ealex/hfBandPassFilterBlock/bandPass2/top.jpg

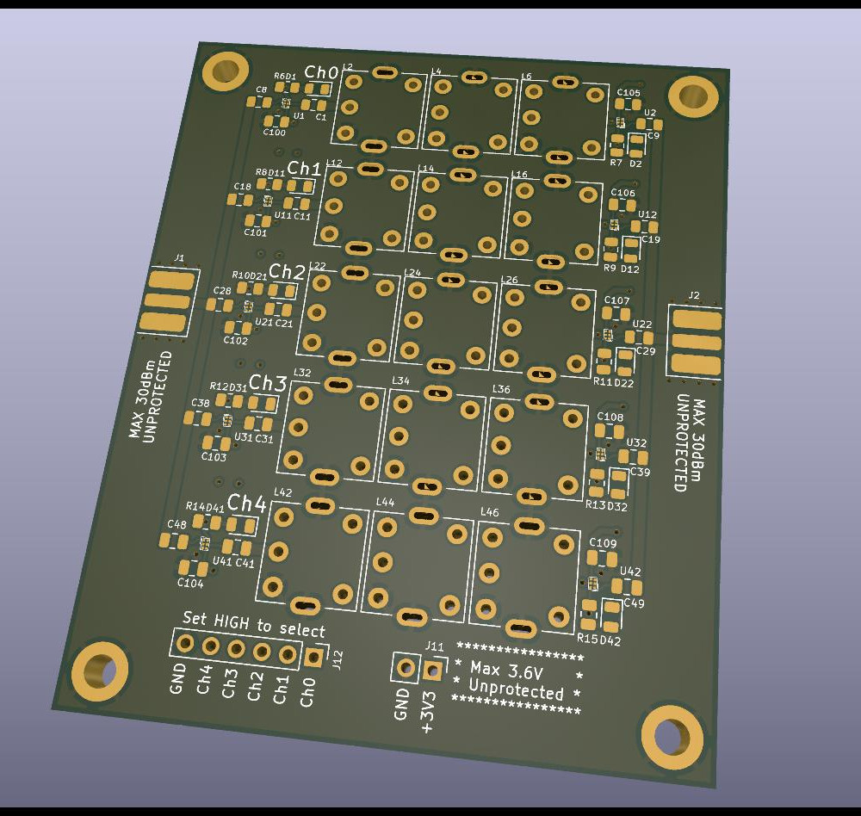
bandPass2/top.jpg
