ealex/hfBandPassFilterBlock/bandPass2/bot.jpg

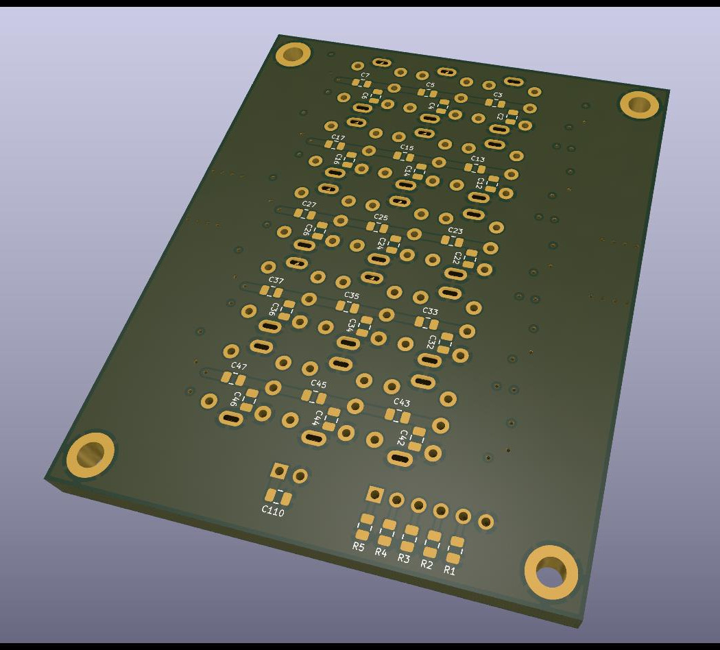
bandPass2/bot.jpg
