ealex/hfBandPassFilterBlock/README.md

# hfBandPassFilterBlock
HF triple tuned band pass filter block

The filter coeficients are computed with https://rf-tools.com/lc-filter/
