ealex/hfBandPassFilterBlock/bandPass2/toko_10k.step

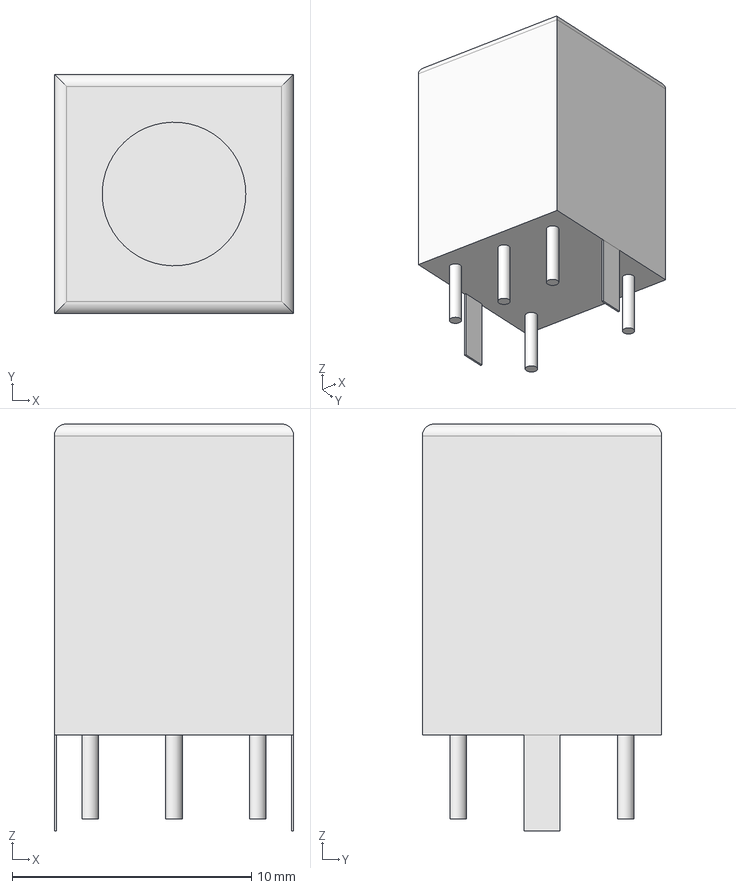
[picture p3: CAD file, 2024-02-06]
bandPass2/toko_10k.step
10.0 x 10.0 x 17.0 mm
