ealex/hfBandPassFilterBlock/bandPass2/bandPass2.pdf

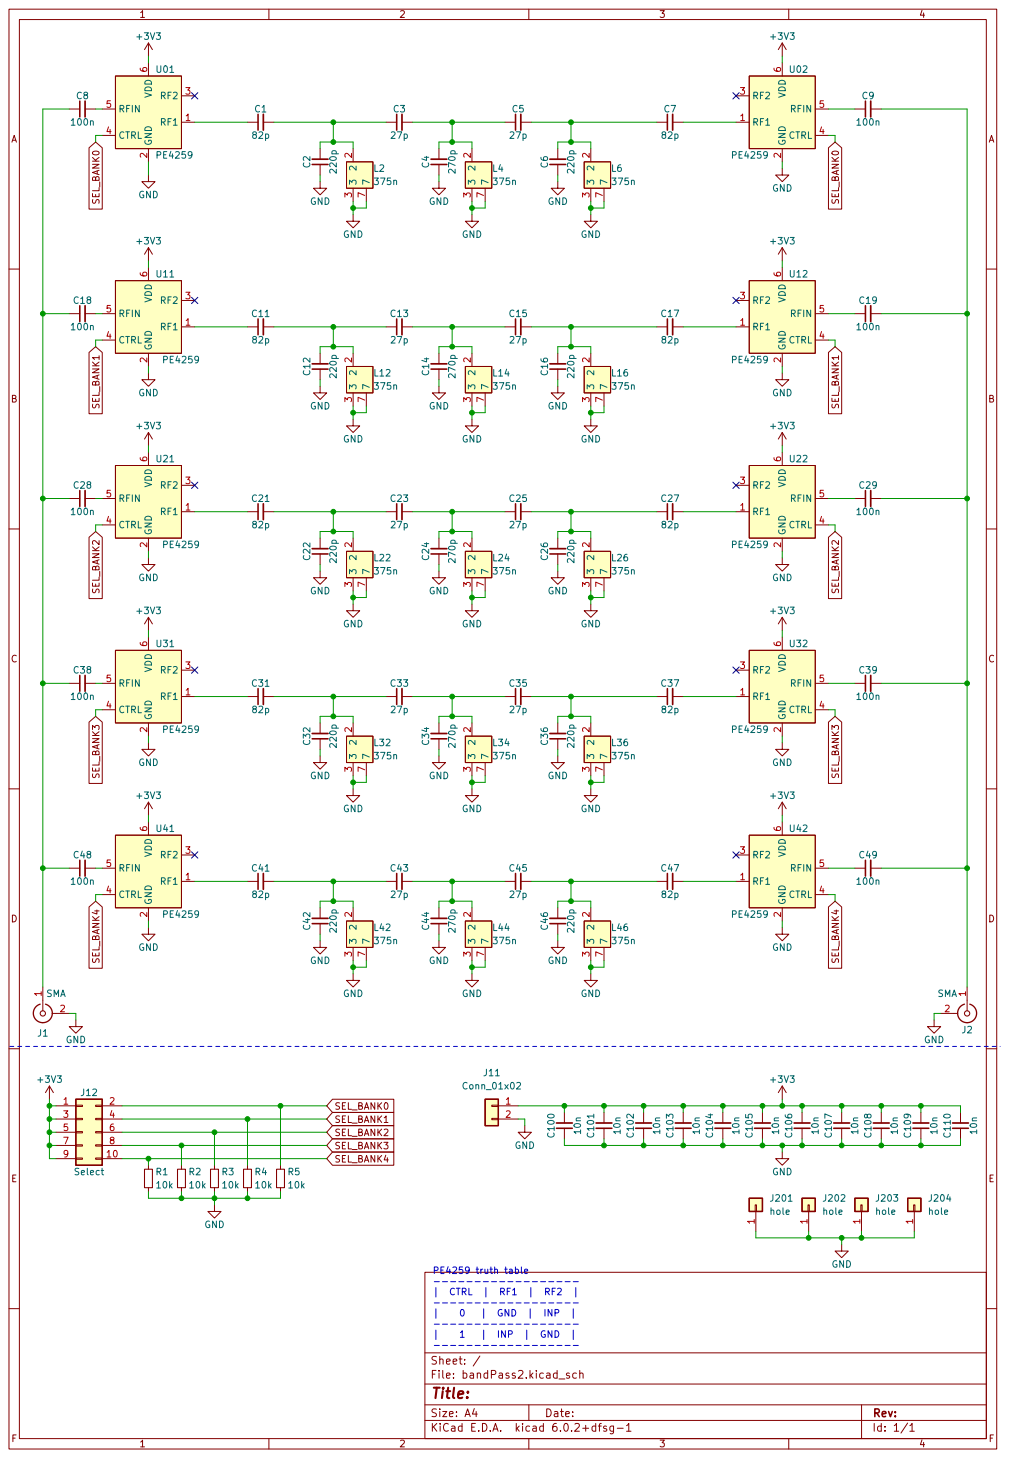
[picture p4: page 1]
