ealex/hfBandPassFilterBlock/bandPass2/bandPass2.kicad_pcb

## KiCad design bandPass2/bandPass2.kicad_pcb (2024-02-06)

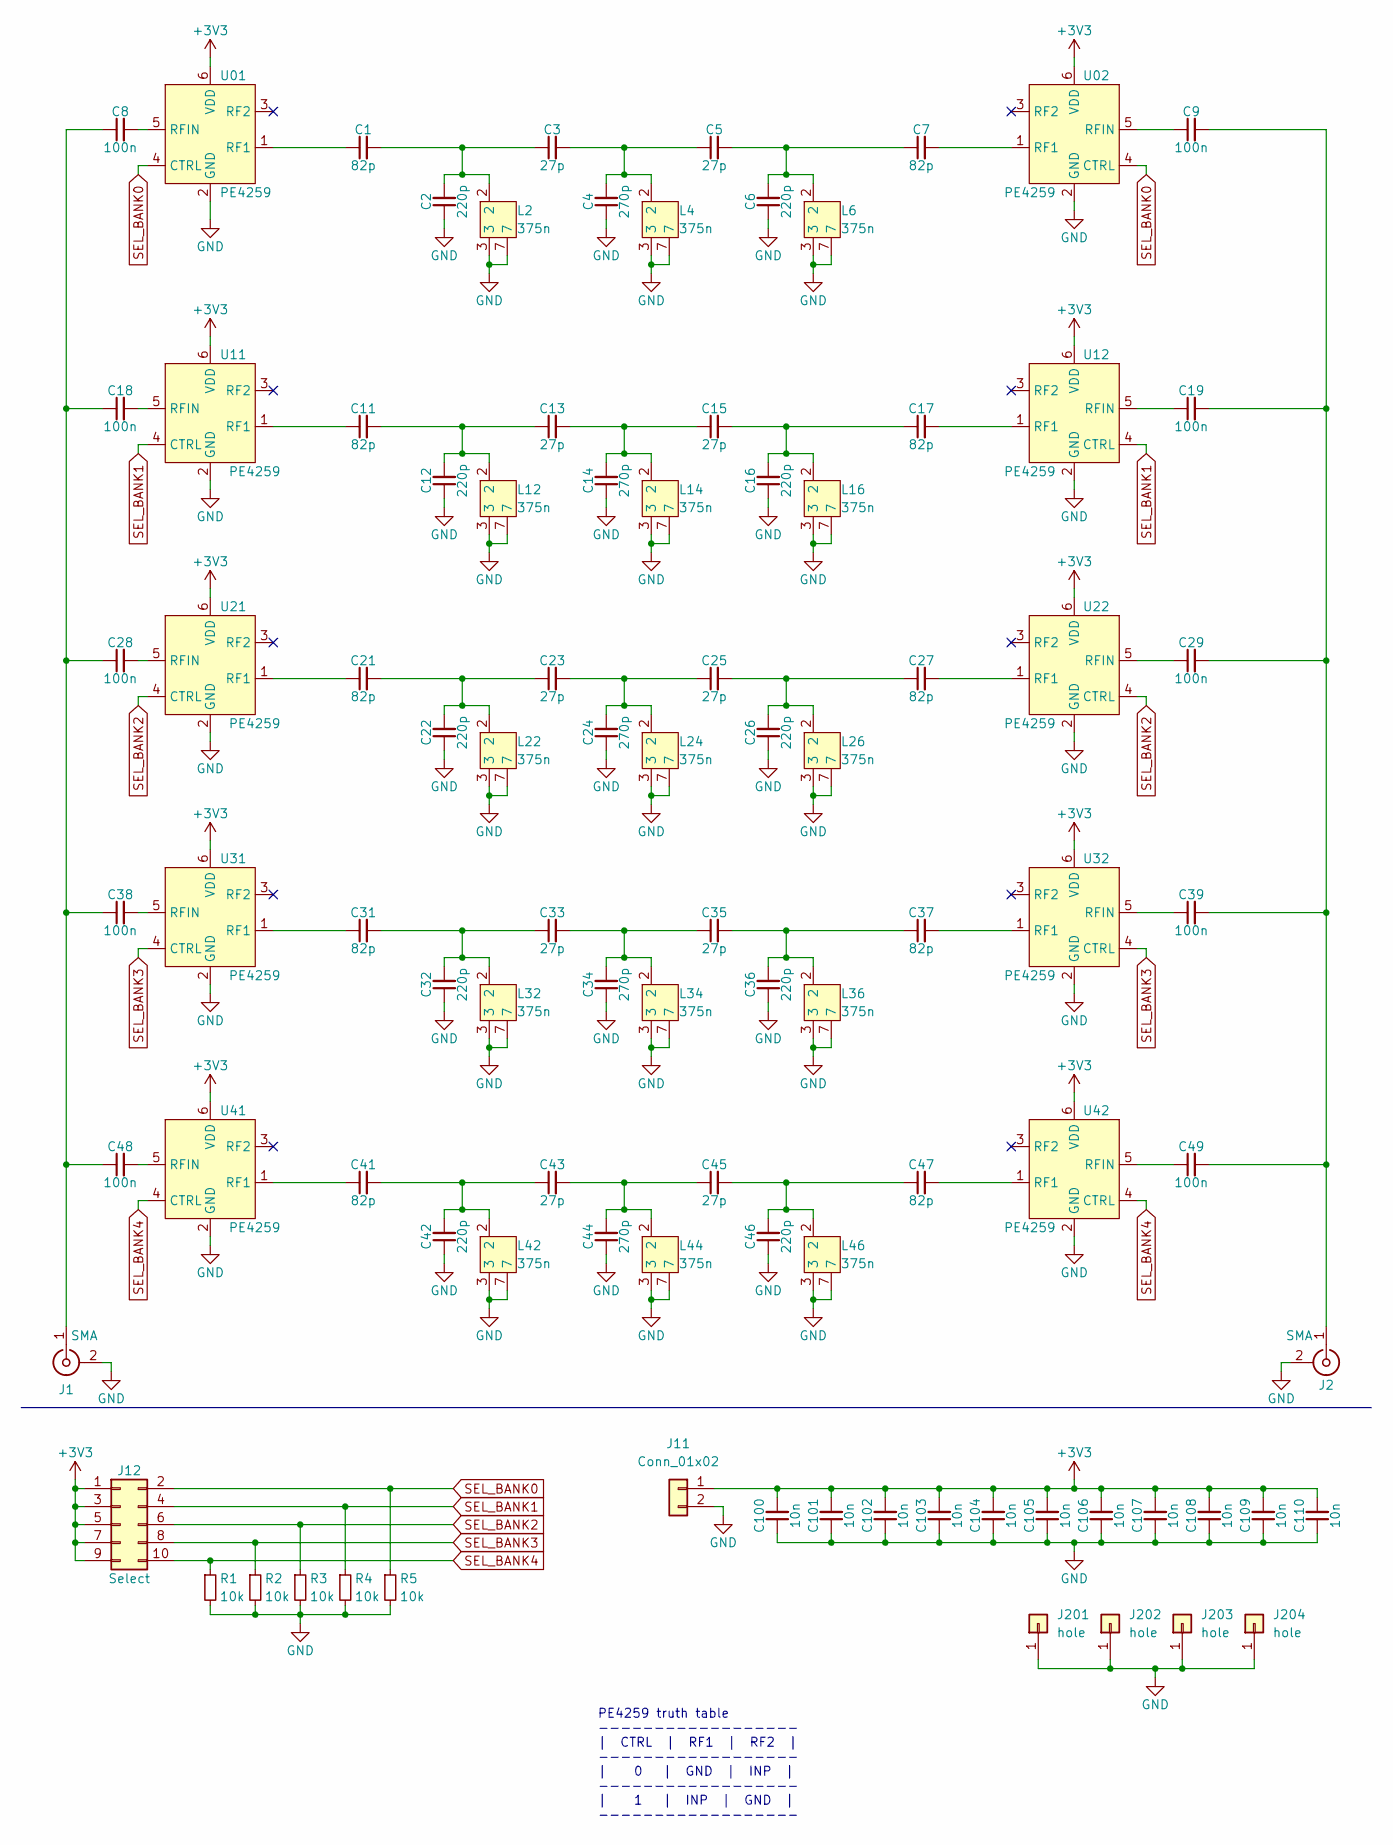
[picture p5: schematic bandPass2.kicad_sch]

Parts:
C1, C7, C11, C17, C21, C27, C31, C37, C41, C47: 82p; C_0805_2012Metric
C2, C6, C12, C16, C22, C26, C32, C36, C42, C46: 220p; C_0805_2012Metric
C3, C5, C13, C15, C23, C25, C33, C35, C43, C45: 27p; C_0805_2012Metric
C4, C14, C24, C34, C44: 270p; C_0805_2012Metric
C8, C9, C18, C19, C28, C29, C38, C39, C48, C49: 100n; C_0805_2012Metric
C100, C101, C102, C103, C104, C105, C106, C107, C108, C109, C110: 10n; C_0805_2012Metric
J1, J2: SMA
J11: Conn_01x02; PinHeader_1x02_P2.54mm_Vertical
J12: Select; PinHeader_2x05_P2.54mm_Vertical
J201, J202, J203, J204: hole; MountingHole_3.2mm_M3_DIN965_Pad
L2, L4, L6, L12, L14, L16, L22, L24, L26, L32, L34, L36, L42, L44, L46: 375n; TOKO_10K
R1, R2, R3, R4, R5: 10k; R_0805_2012Metric
U01, U02, U11, U12, U21, U22, U31, U32, U41, U42: PE4259; SOT-363_SC-70-6

Connections:
+3V3: C100.2, C101.2, C102.2, C103.2, C104.2, C105.2, C106.2, C107.2, C108.2, C109.2, C110.2, J11.1, J12.1, J12.3, J12.5, J12.7, J12.9, U01.6 (VDD), U02.6 (VDD), U11.6 (VDD), U12.6 (VDD), U21.6 (VDD), U22.6 (VDD), U31.6 (VDD), U32.6 (VDD), U41.6 (VDD), U42.6 (VDD)
GND: C2.1, C4.1, C6.1, C12.1, C14.1, C16.1, C22.1, C24.1, C26.1, C32.1, C34.1, C36.1, C42.1, C44.1, C46.1, C100.1, C101.1, C102.1, C103.1, C104.1, C105.1, C106.1, C107.1, C108.1, C109.1, C110.1, J1.2 (Ext), J2.2 (Ext), J11.2, J201.1, J202.1, J203.1, J204.1, L2.3, L2.7, L4.3, L4.7, L6.3, L6.7, L12.3, L12.7, L14.3, L14.7, L16.3, L16.7, L22.3, L22.7, L24.3, L24.7, L26.3, L26.7, L32.3, L32.7, L34.3, L34.7, L36.3, L36.7, L42.3, L42.7, L44.3, L44.7, L46.3, L46.7, R1.2, R2.2, R3.2, R4.2, R5.2, U01.2 (GND), U02.2 (GND), U11.2 (GND), U12.2 (GND), U21.2 (GND), U22.2 (GND), U31.2 (GND), U32.2 (GND), U41.2 (GND), U42.2 (GND)
unnamed: C1.1, U01.1 (RF1)
unnamed: C1.2, C2.2, C3.1, L2.2
unnamed: C3.2, C4.2, C5.1, L4.2
unnamed: C5.2, C6.2, C7.1, L6.2
unnamed: C7.2, U02.1 (RF1)
unnamed: C8.2, U01.5 (RFIN)
unnamed: C9.1, U02.5 (RFIN)
unnamed: C11.1, U11.1 (RF1)
unnamed: C11.2, C12.2, C13.1, L12.2
unnamed: C13.2, C14.2, C15.1, L14.2
unnamed: C15.2, C16.2, C17.1, L16.2
unnamed: C17.2, U12.1 (RF1)
unnamed: C8.1, C18.1, C28.1, C38.1, C48.1, J1.1 (In)
unnamed: C18.2, U11.5 (RFIN)
unnamed: C19.1, U12.5 (RFIN)
unnamed: C9.2, C19.2, C29.2, C39.2, C49.2, J2.1 (In)
unnamed: C21.1, U21.1 (RF1)
unnamed: C21.2, C22.2, C23.1, L22.2
unnamed: C23.2, C24.2, C25.1, L24.2
unnamed: C25.2, C26.2, C27.1, L26.2
unnamed: C27.2, U22.1 (RF1)
unnamed: C28.2, U21.5 (RFIN)
unnamed: C29.1, U22.5 (RFIN)
unnamed: C31.1, U31.1 (RF1)
unnamed: C31.2, C32.2, C33.1, L32.2
unnamed: C33.2, C34.2, C35.1, L34.2
unnamed: C35.2, C36.2, C37.1, L36.2
unnamed: C37.2, U32.1 (RF1)
unnamed: C38.2, U31.5 (RFIN)
unnamed: C39.1, U32.5 (RFIN)
unnamed: C41.1, U41.1 (RF1)
unnamed: C41.2, C42.2, C43.1, L42.2
unnamed: C43.2, C44.2, C45.1, L44.2
unnamed: C45.2, C46.2, C47.1, L46.2
unnamed: C47.2, U42.1 (RF1)
unnamed: C48.2, U41.5 (RFIN)
unnamed: C49.1, U42.5 (RFIN)
SEL_BANK0: J12.2, R5.1, U01.4 (CTRL), U02.4 (CTRL)
SEL_BANK1: J12.4, R4.1, U11.4 (CTRL), U12.4 (CTRL)
SEL_BANK2: J12.6, R3.1, U21.4 (CTRL), U22.4 (CTRL)
SEL_BANK3: J12.8, R2.1, U31.4 (CTRL), U32.4 (CTRL)
SEL_BANK4: J12.10, R1.1, U41.4 (CTRL), U42.4 (CTRL)

Notes on the sheet:
PE4259 truth table ------------------ | CTRL | RF1 | RF2 | ------------------ | 0 | GND | INP | ------------------ | 1 | INP | GND | ------------------

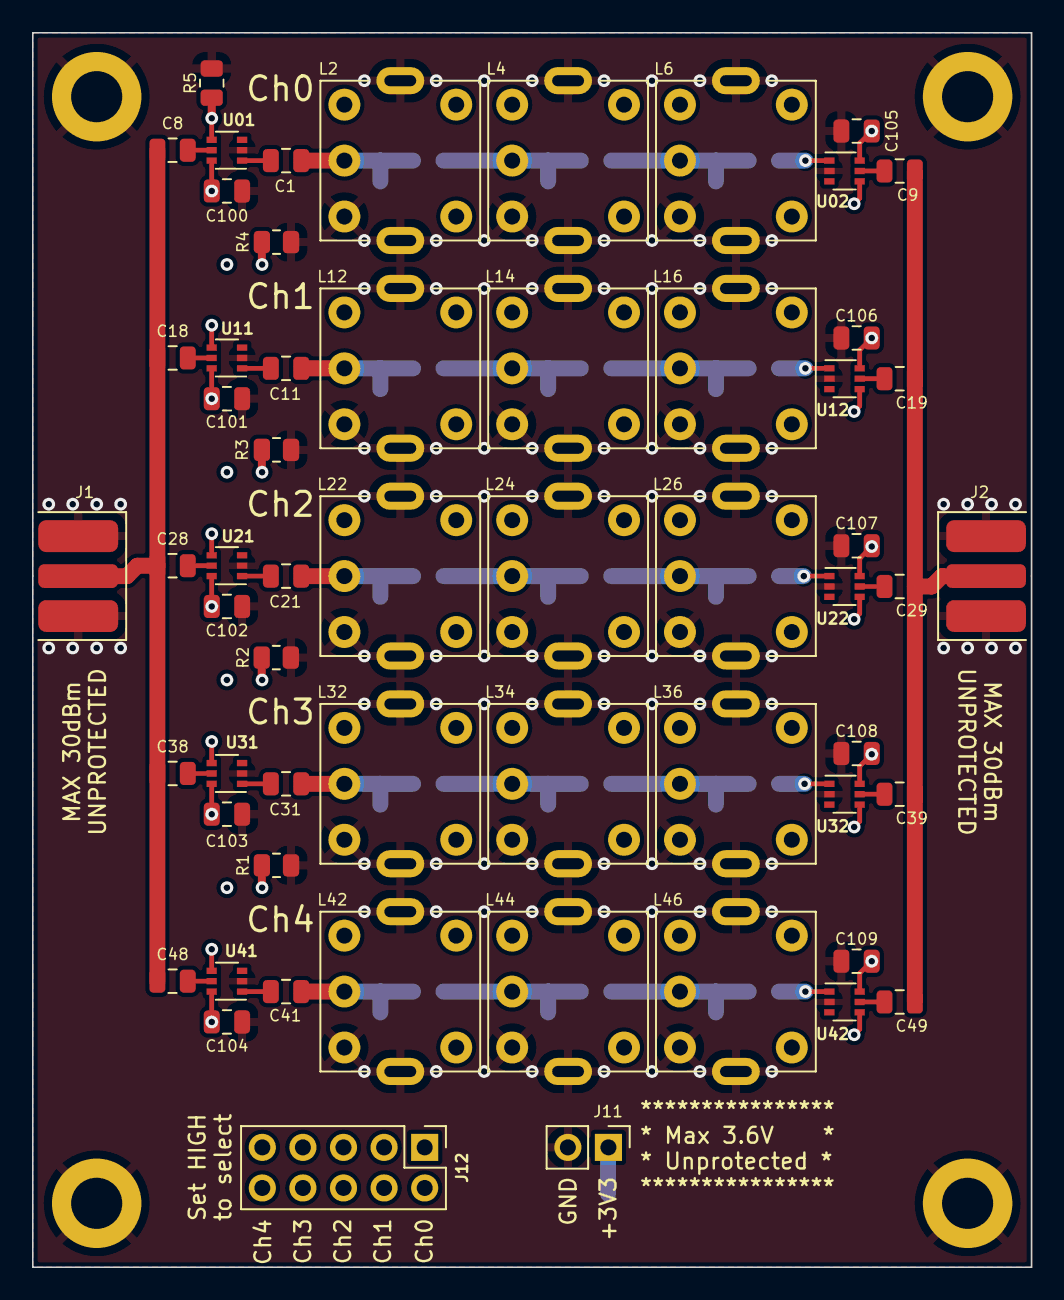
[picture p6: board bandPass2.kicad_pcb from above]

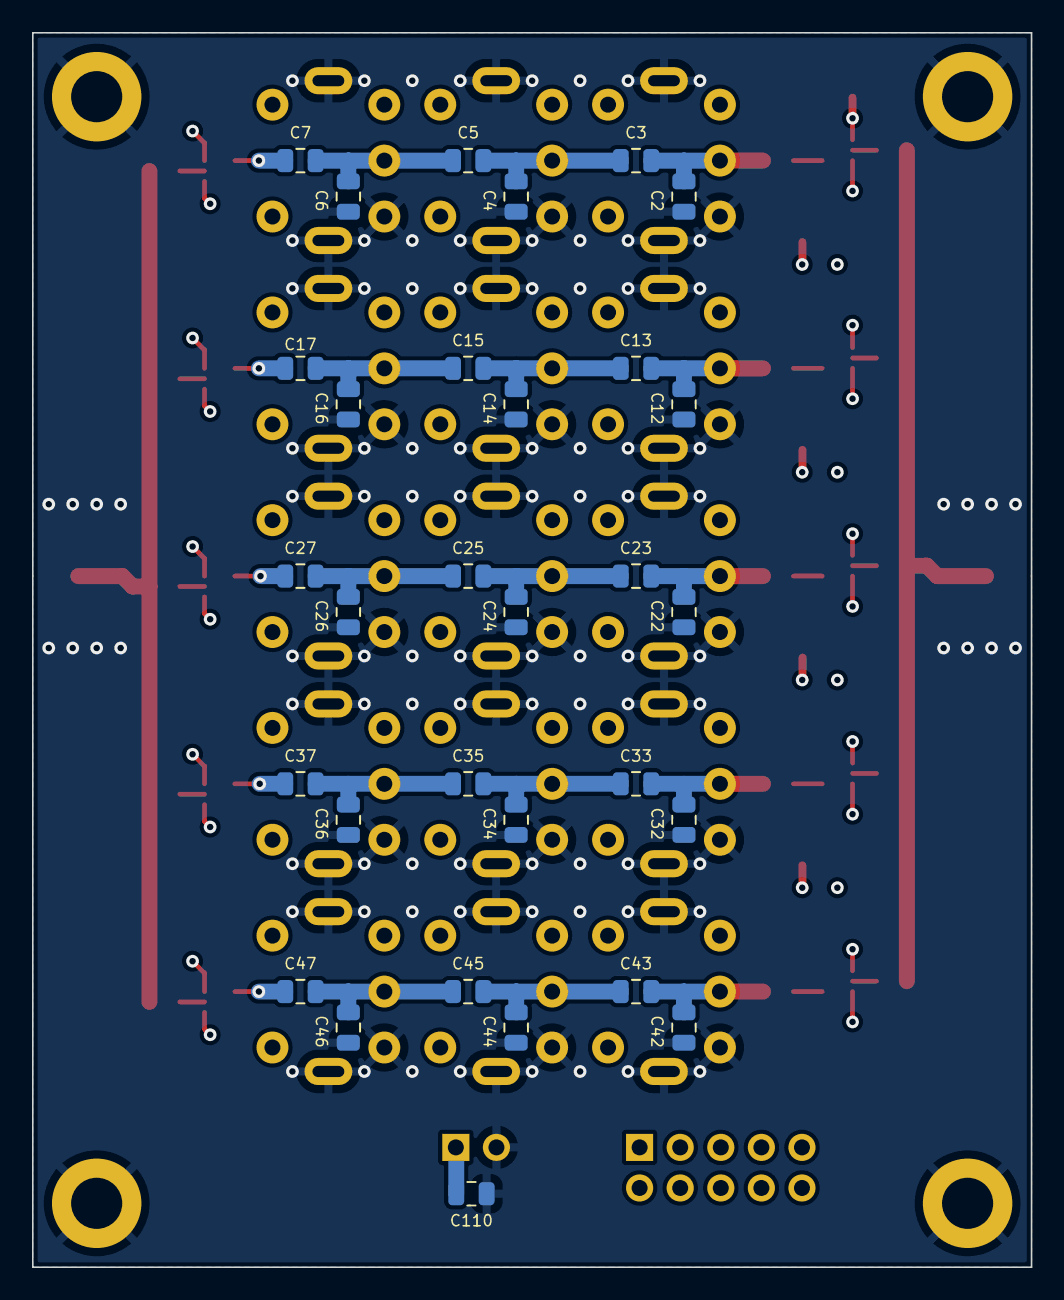
[picture p7: board bandPass2.kicad_pcb from below]

Board: 4 copper layers, 62.5 x 77.2 mm, 94 parts (31 on the bottom side), 44 nets.
