ealex/hfBandPassFilterBlock/calibrare/3.5-4.2MHz_full_sweep_data.jpg

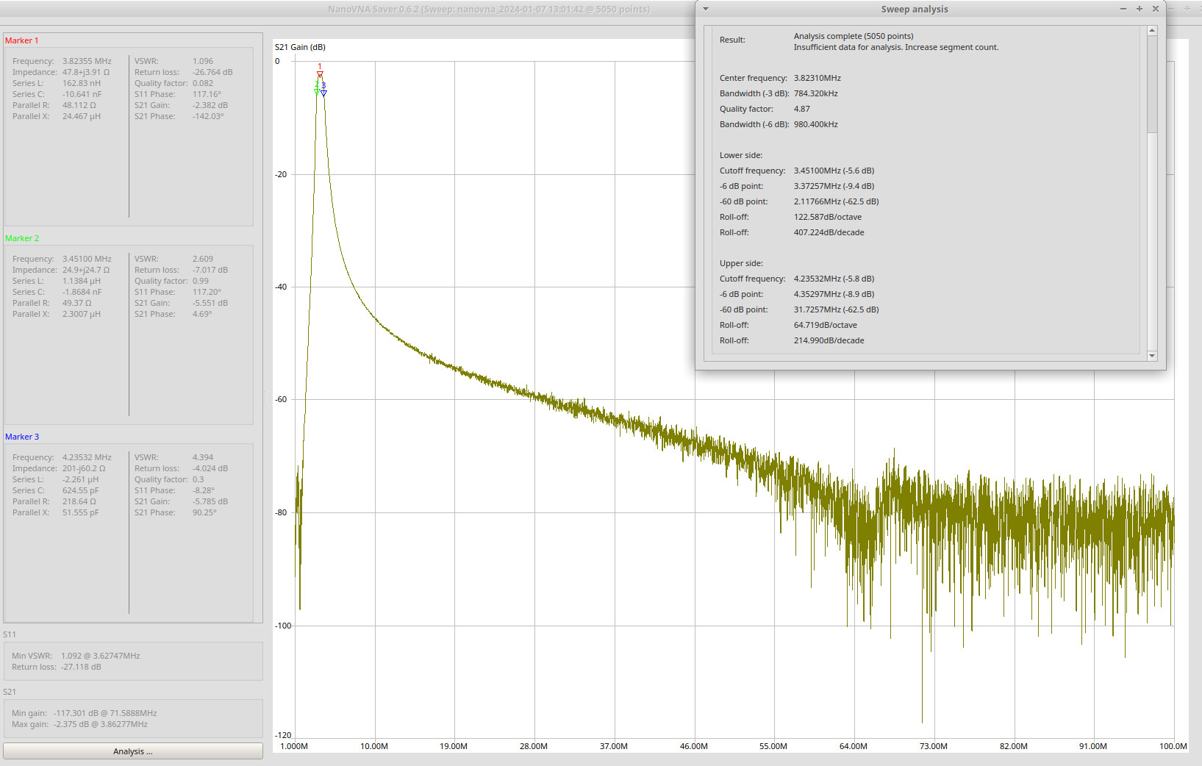
calibrare/3.5-4.2MHz_full_sweep_data.jpg
