ealex/hfBandPassFilterBlock/calibrare/3.5-4.2MHz_return_loss.jpg

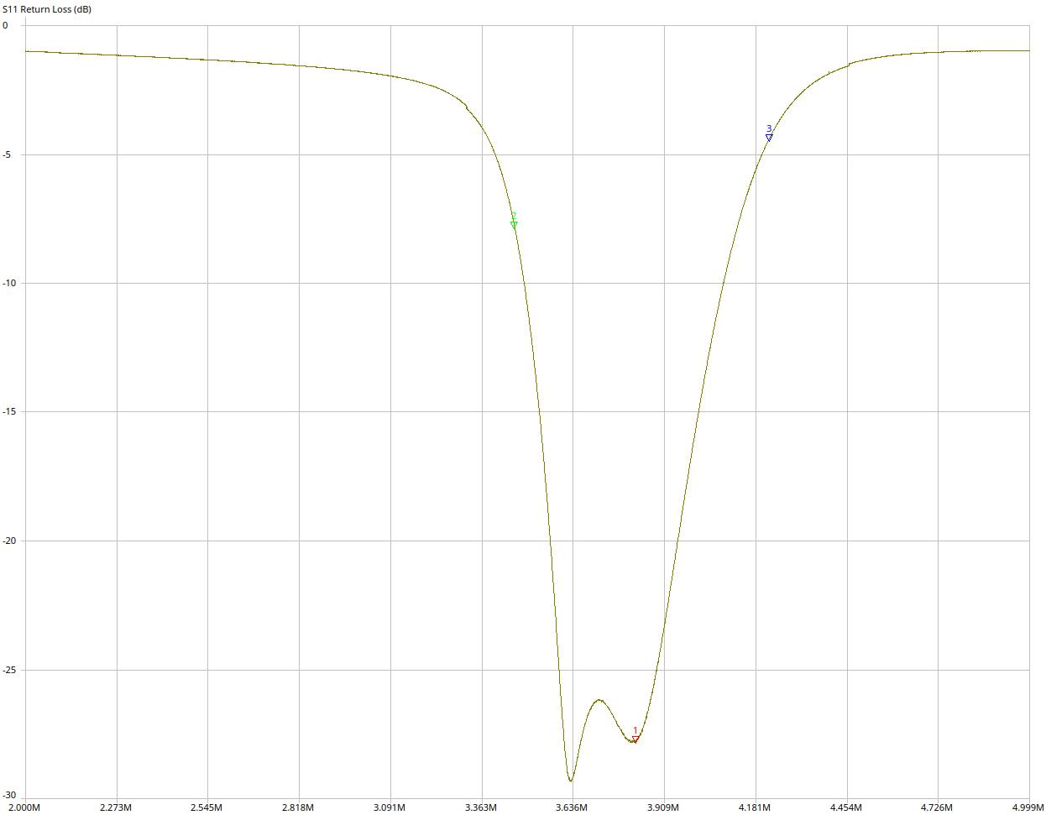
calibrare/3.5-4.2MHz_return_loss.jpg
