ealex/hfBandPassFilterBlock/calibrare/6.8MHz_7.6MHz_detail.jpg

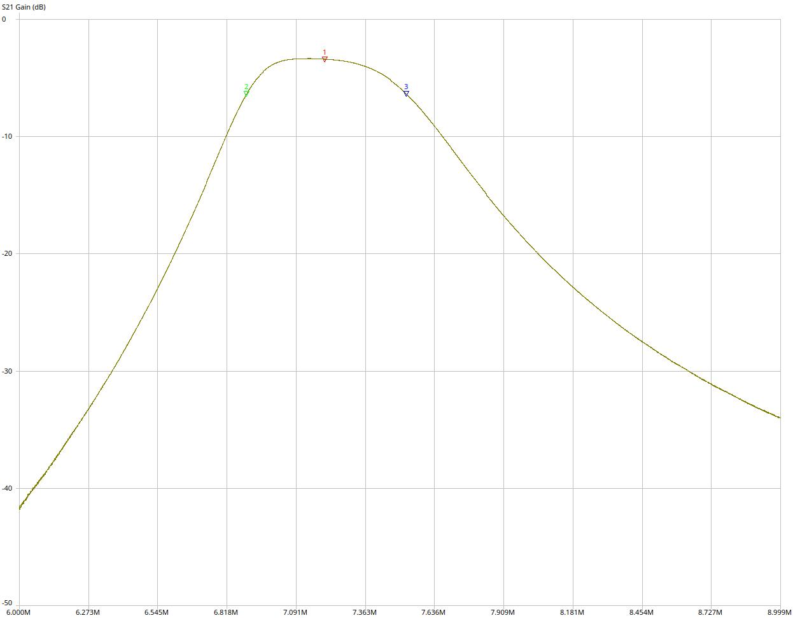
calibrare/6.8MHz_7.6MHz_detail.jpg
