ealex/hfBandPassFilterBlock/calibrare/6.8MHz_7.6MHz_full_sweep.jpg

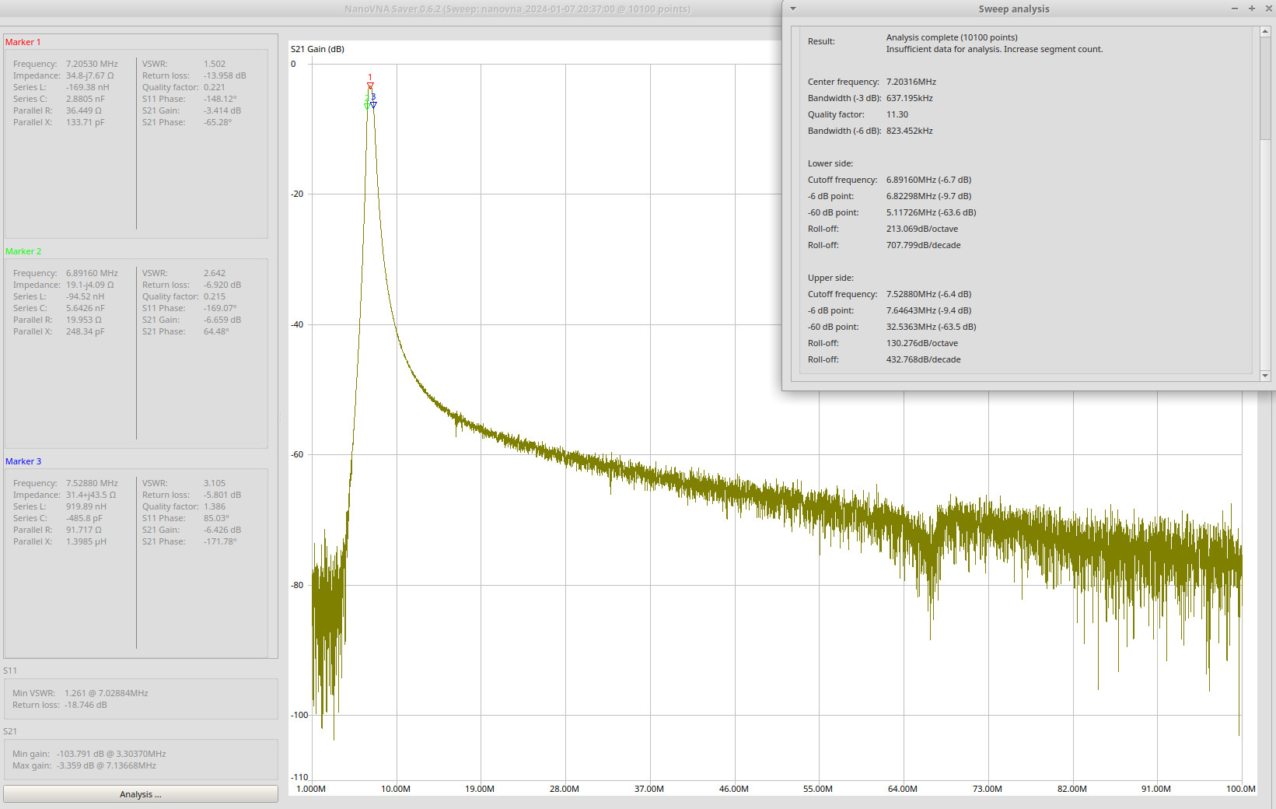
calibrare/6.8MHz_7.6MHz_full_sweep.jpg
