ealex/hfBandPassFilterBlock/calibrare/13.4MHz_14.5MHz_detail.jpg

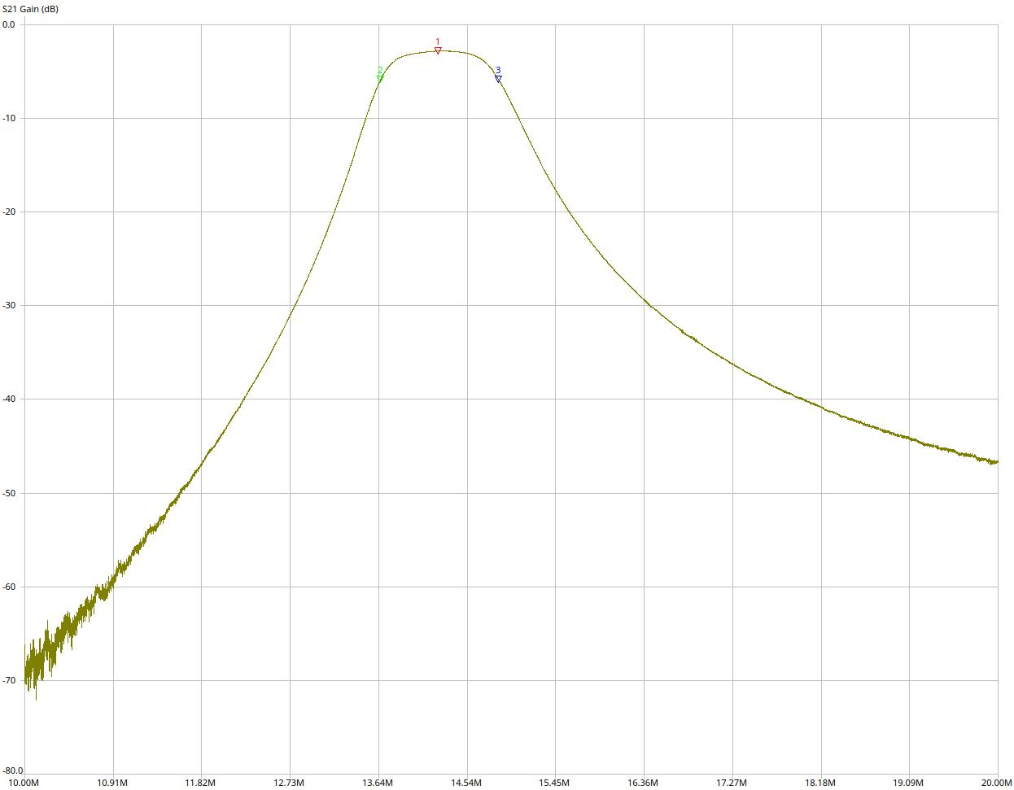
calibrare/13.4MHz_14.5MHz_detail.jpg
