ealex/hfBandPassFilterBlock/calibrare/13.4MHz_14.5MHz_full_sweep.jpg

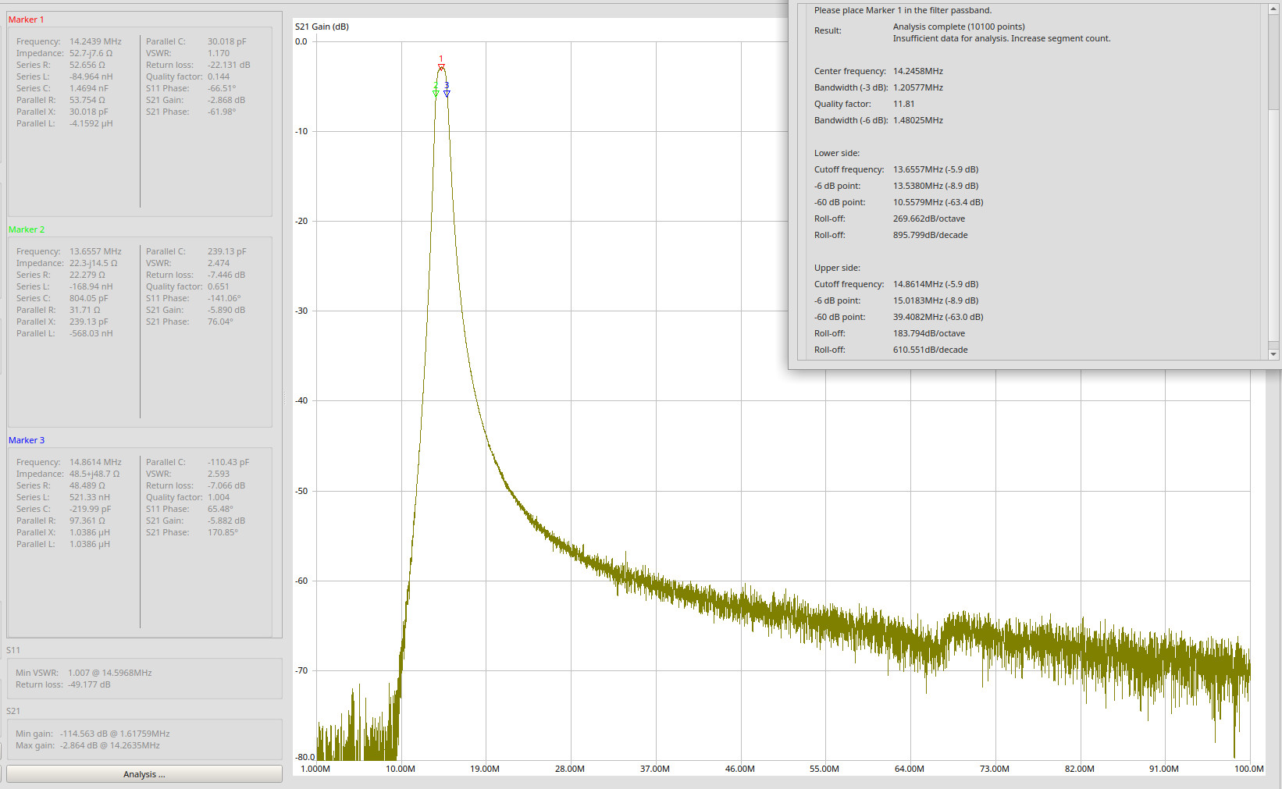
calibrare/13.4MHz_14.5MHz_full_sweep.jpg
