ealex/hfBandPassFilterBlock/calibrare/20MHz_22MHz_detail.jpg

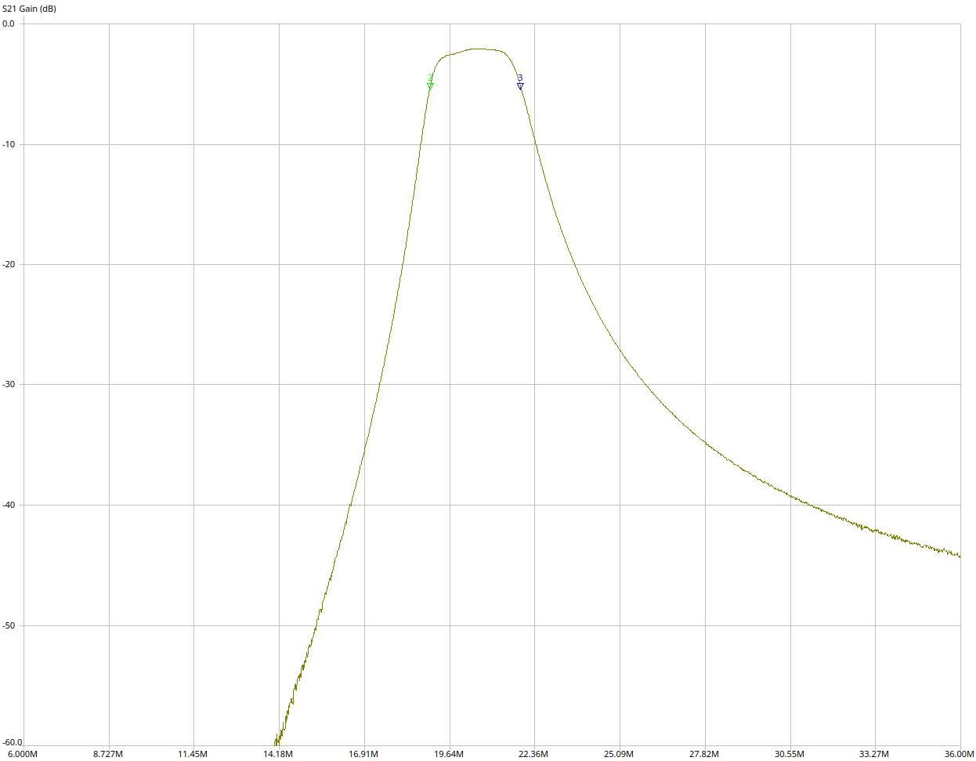
calibrare/20MHz_22MHz_detail.jpg
