ealex/hfBandPassFilterBlock/calibrare/20MHz_22MHz_full_sweep.jpg

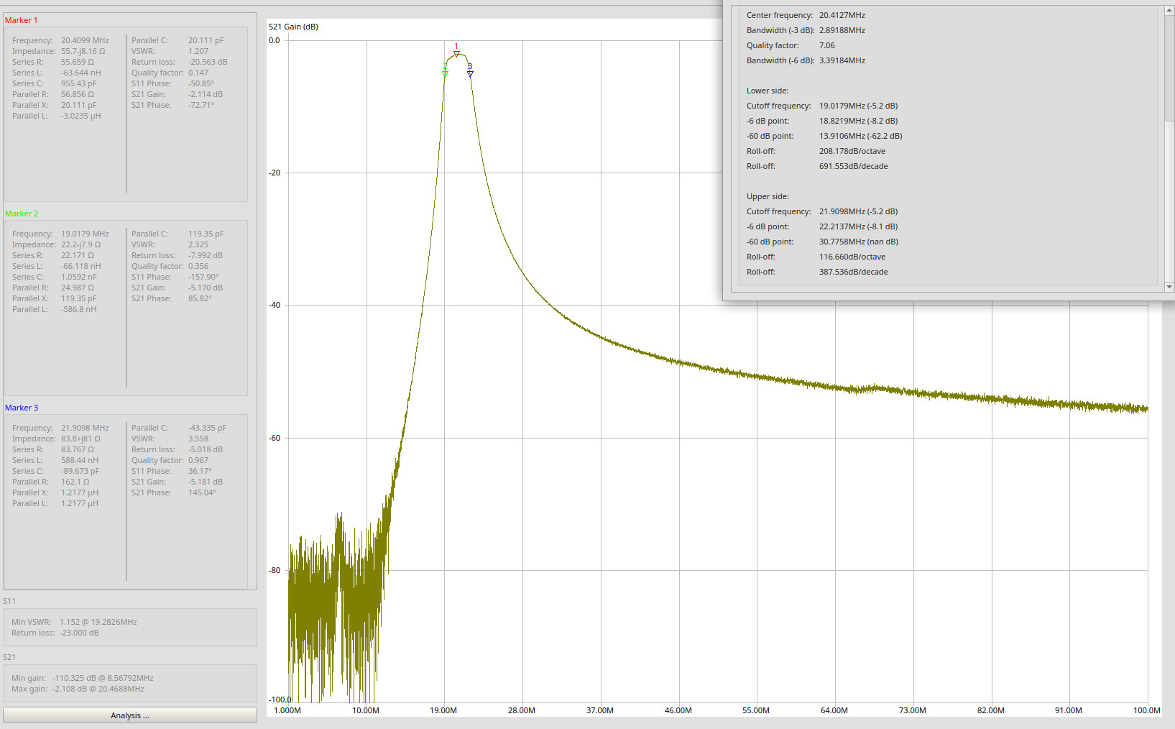
calibrare/20MHz_22MHz_full_sweep.jpg
