ealex/hfBandPassFilterBlock/calibrare/27MHz_30MHz_detail.jpg

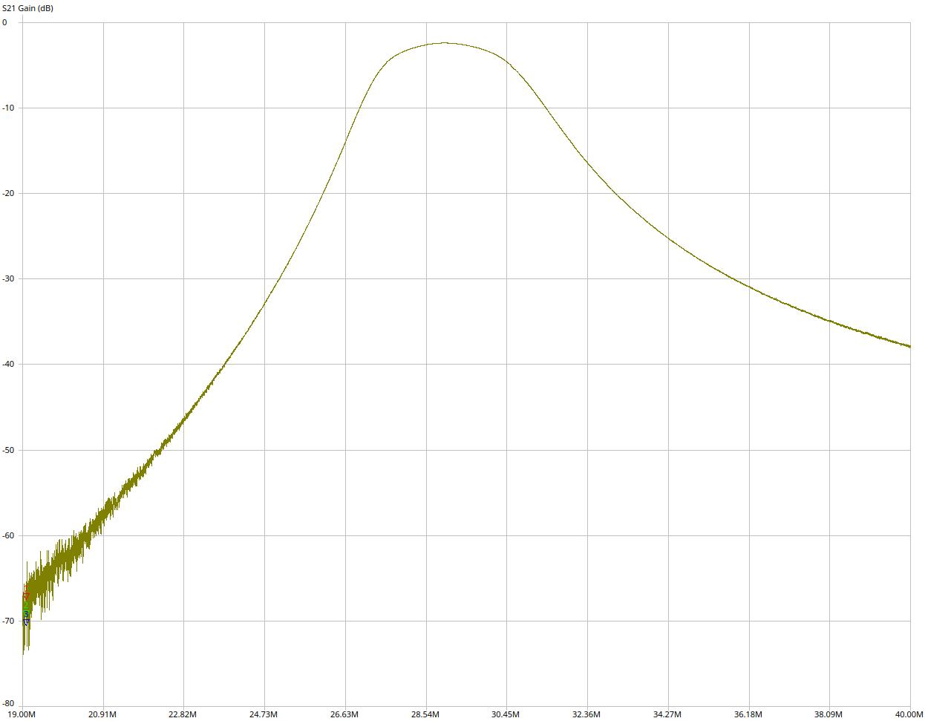
calibrare/27MHz_30MHz_detail.jpg
