ealex/hfBandPassFilterBlock/calibrare/27MHz_30MHz_full_sweep.jpg

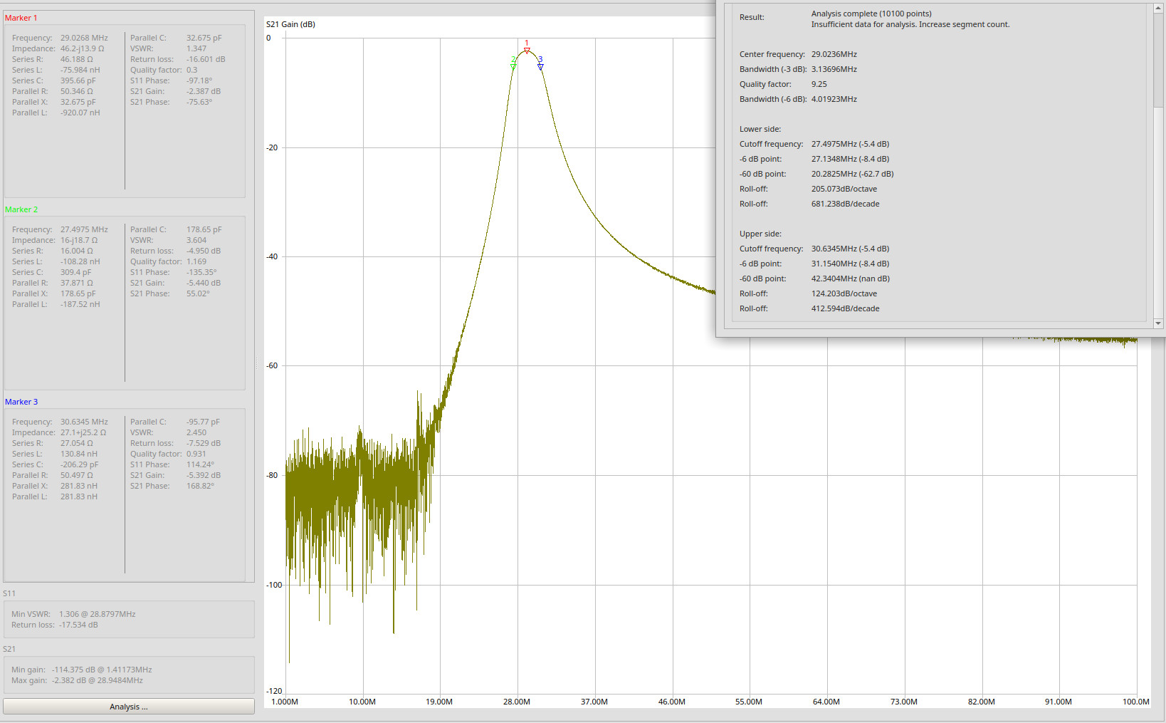
calibrare/27MHz_30MHz_full_sweep.jpg
