ealex/hfBandPassFilterBlock/calibrare/no_filter_selected.jpg

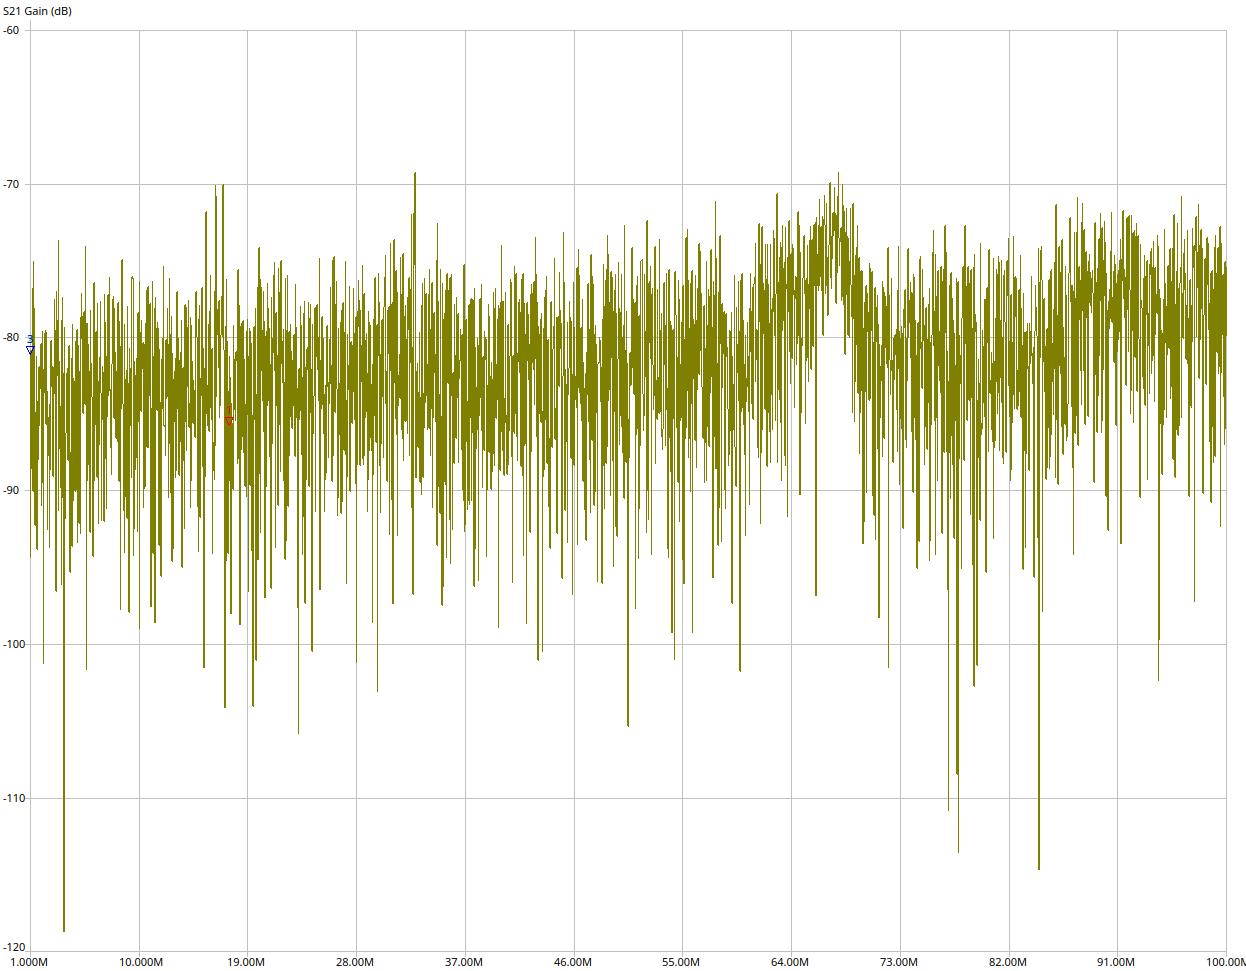
calibrare/no_filter_selected.jpg
