ealex/hfBandPassFilterBlock/(commit log)

2023-08-31 add RF switch and filter coil
2023-08-31 filter coeficients file
    [filters.ods]
2023-08-31 add schematic
    [bandPass2.kicad_pcb, bandPass2.kicad_sch]
2023-08-31 add pdf schematic
2023-08-31 pcb clean-up
    [bandPass2.kicad_pcb]
2023-08-31 clean-up, add pcb render
    [bandPass2.kicad_pcb]
2023-08-31 add bom
    [bandPass2.kicad_pcb]
2023-11-07 add PE4259 switch
2023-11-07 Add TOKO 10K 3d model
    [toko_10k.step]
2023-11-07 update schematic and pcb
    [bandPass2.kicad_pcb, bandPass2.kicad_sch]
2024-01-09 start defining filter banks
2024-01-11 add new filters
2024-02-06 add last filter
